pavel-demin/flashlight/pcb/programmer.kicad_pcb

## KiCad design pcb/programmer.kicad_pcb (2019-02-18)

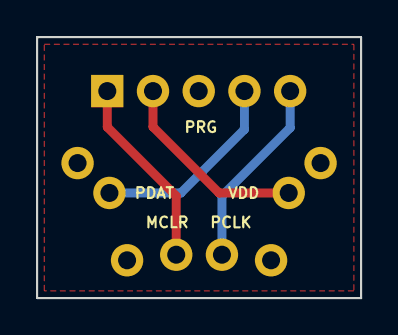
[picture p1: board programmer.kicad_pcb from above]

Board: 2 copper layers, 18.0 x 14.5 mm, 9 parts (0 on the bottom side), 5 nets.

Parts:
MCLR: MCLR; PIN-1.0mm
PCLK: PCLK; PIN-1.0mm
PDAT: PDAT; PIN-1.0mm
PIN1, PIN2, PIN3, PIN4: PIN; PIN-1.0mm
PRG: PRG; Pin_Header_Straight_1x05_Pitch2.54mm
VDD: VDD; PIN-1.0mm

Connections:
GND: PIN1.1, PIN2.1, PIN3.1, PIN4.1, PRG.3
unnamed: PRG.2, VDD.1
unnamed: PCLK.1, PRG.5
unnamed: PDAT.1, PRG.4
unnamed: MCLR.1, PRG.1
