pavel-demin/flashlight/pcb/flashlight.kicad_pcb

## KiCad design pcb/flashlight.kicad_pcb (2017-04-02)

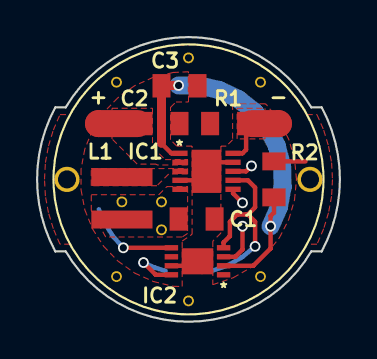
[picture p2: board flashlight.kicad_pcb from above]

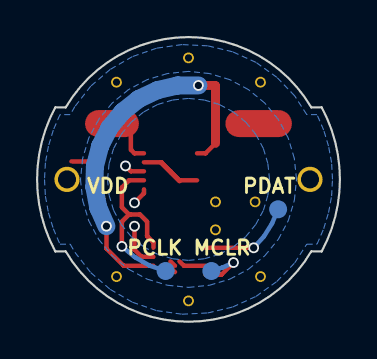
[picture p3: board flashlight.kicad_pcb from below]

Board: 2 copper layers, 16.8 x 15.8 mm, 25 parts (4 on the bottom side), 9 nets.

Parts:
+: +LED; PAD-1.5mm
-: LED-; PAD-1.5mm
C1: 10u; 0805
C2: 22u; 0805
C3: 1u; 0805
IC1: TPS61200; DRC
IC2: PIC10F320; MC
L1: 2.2u; XFL4020
MCLR: MCLR; PAD-1.0mm
PCLK: PCLK; PAD-1.0mm
PDAT: PDAT; PAD-1.0mm
PIN1, PIN2: PIN; PIN-1.0mm
R1: 2; 0805
R2: 1M; 0805
VDD: VDD; PAD-1.0mm
VIA1, VIA2, VIA3, VIA4, VIA5, VIA6, VIA7, VIA8, VIA9: VIA; VIA-0.6mm

Connections:
GND: C1.2, C2.2, C3.2, IC1.4, IC1.9, IC1.11, IC2.7, IC2.9, PIN1.1, PIN2.1, R1.2, R2.1, VIA4.1, VIA5.1, VIA6.1, VIA7.1, VIA8.1, VIA9.1
unnamed: IC1.3, L1.2
unnamed: +.1, C2.1, IC1.2
unnamed: C3.1, IC1.1, IC2.2, R2.2, VDD.1
unnamed: IC1.7, IC2.4, PCLK.1
unnamed: -.1, IC1.10, R1.1
unnamed: IC2.5, PDAT.1
unnamed: IC2.8, MCLR.1
SUPPLY: C1.1, IC1.5, IC1.6, IC1.8, IC2.3, L1.1, VIA1.1, VIA2.1, VIA3.1
