pavel-demin/flashlight/(commit log)

2017-03-05 set pcb radius to 7.9 mm
    [flashlight.kicad_pcb]
2017-03-06 add PIN-1.0mm
2017-03-06 add PIN part
2017-03-06 reduce VIA-0.6mm fonts
2017-03-06 move programming pads to bottom and add support extensions
    [flashlight.kicad_pcb]
2017-03-07 reduce radius of supply mask and move supply vias
    [flashlight.kicad_pcb]
2017-03-07 increase reference font size
    [flashlight.kicad_pcb]
2017-03-07 increase width of the vdd and led traces
    [flashlight.kicad_pcb]
2017-03-07 enlarge gnd zone
    [flashlight.kicad_pcb]
2017-03-07 reduce number of corners in circular zones
    [flashlight.kicad_pcb]
2017-03-11 add battery undervoltage protection
2017-03-11 measure supply voltage 30 times per second
2017-03-11 use timer interrupt for debouncing
2017-03-11 simplify mode switching
2017-03-12 set clock frequency to 1 MHz, remove interrupt code and add subroutines
2017-03-13 replace 10k with 470k
    [flashlight.kicad_pcb]
2017-03-14 add flashlight-pwm.asm
2017-04-02 connect R2 to GND
    [flashlight.kicad_pcb]
2019-02-18 fix pin function in parts_sklib.py
2019-02-18 add programmer.kicad_pcb
    [programmer.kicad_pcb]
2019-02-20 enlarge VIA-0.6mm fonts
2019-02-20 rename wires in flashlight.tcl
